kaymantex68/Skruber_Tehnoplast/документация/1.Титульный лист.pdf

| Номер изделия 38.51
Рев. 0 | Дата 22-06-2021

Лабораторный шкаф. Электрическая схема.
