kaymantex68/Skruber_Tehnoplast/Список элементов.xlsx

Позиция | Наименование (номенклатура) | Магазин | Кол-во | Цена со скидкой | Розница | Сумма скидка | Сумма Розинца | Итого скидка | Итого Розинца
1 | Автоматический выключатель Schneider electric iC60N C16A 3p | Авито | 1.00 | 1000.00 | 3200.00 | 1000.00 | 3200.00 | 32667.20 | 40877.00
2 | Автомат защиты двигателя 1,6-2,5A GZ1E07 Schneider Electric | АВС | 2.00 | 1869.60 | 2280.00 | 3739.20 | 4560.00
3 | Автомат пуска двигателя ABB 6.3-10А MS116 | ЭТМ | 1.00 | 2009.00 | 2500.00 | 2009.00 | 2500.00
4 | Выключатель автоматический C 16А 1P 6000A Resi9 R9F12116 | ЭТМ | 2.00 | 191.00 | 231.00 | 382.00 | 462.00
5 | Выключатель автоматический C 6А 1P 6000A Resi9 | ЭТМ | 1.00 | 280.00 | 320.00 | 280.00 | 320.00
6 | Контактор 3-пол., 9А 400В AC3 220В 50ГЦ, 1но LC1E0910M5 Schneider electric | АВС | 3.00 | 593.00 | 739.00 | 1779.00 | 2217.00
7 | Реле 4 перекл. контакта 6А 230В AC RXM4AB1P7 Schneider electric | АВС | 1.00 | 602.00 | 865.00 | 602.00 | 865.00
8 | Комплект тонкое реле + розетка 1п/к, 6А, 230В АС/DC, винт. Клемма RSL1PVPU Schneider Electric | АВС | 1.00 | 627.00 | 967.00 | 627.00 | 967.00
9 | Шина нулевая в комбинированном DIN-изоляторе типа "Стойка" ШНИ-8х12-8-КС-С ИЭК | АВС | 2.00 | 134.00 | 220.00 | 268.00 | 440.00
10 | Ящик пластиковый IEK | Русский Свет | 1.00 | 2500.00 | 3800.00 | 2500.00 | 3800.00
11 | DIN-рейка 35х7,5 мм длиной 600 мм | АВС | 1.00 | 238.00 | 309.00 | 238.00 | 309.00
12 | Кабель-канал перфорир. 25х30 5/8 ДКС | АВС | 1.00 | 164.00 | 215.00 | 164.00 | 215.00
13 | Клемма пружинная ST 2,5 мм2 серая BU Phoenix Contact | АВС | 27.00 | 31.00 | 58.00 | 837.00 | 1566.00
14 | Клемма пружинная ST 2,5 мм2 синяя BU Phoenix Contact | АВС | 5.00 | 31.00 | 58.00 | 155.00 | 290.00
15 | Клемма пружинная ST 2,5-TWIN Phoenix Contact | АВС | 2.00 | 40.00 | 65.00 | 80.00 | 130.00
16 | Клемма втычная PT 2,5-PE ж/з Phoenix Contact | АВС | 4.00 | 161.00 | 240.00 | 644.00 | 960.00
17 | Перемычка Phoenix contact | АВС | 1.00 | 150.00 | 180.00 | 150.00 | 180.00
18 | Заглушка | АВС | 4.00 | 20.00 | 30.00 | 80.00 | 120.00
19 | Концевой стопор CLIPFIX 35-5 V0 Phoenix Contact | АВС | 9.00 | 34.00 | 48.00 | 306.00 | 432.00
20 | Маркировка ONKA |  | 1.00 | 240.00 | 240.00 | 240.00 | 240.00
21 | Кнопка зеленая (1НО/1НЗ) XB7NA35 | АВС | 1.00 | 248.00 | 300.00 | 248.00 | 300.00
22 | Кнопка красная (1НО/1НЗ) XB7NA45 | АВС | 1.00 | 248.00 | 300.00 | 248.00 | 300.00
23 | Ревунок | Яндекс | 1.00 | 450.00 | 450.00 | 450.00 | 450.00
24 | ТДМ переключатель с лампочкой | Яндекс | 1.00 | 430.00 | 430.00 | 430.00 | 430.00
25 | Сигнальная лампа-светодиод зеленая 230В XB7EV03MP | АВС | 3.00 | 201.00 | 242.00 | 603.00 | 726.00
26 | Переключатель черный 2 пол. с фикс. (1НО+1НЗ) XB7ND25 | АВС | 1.00 | 422.00 | 509.00 | 422.00 | 509.00
27 | Коробка Влагостойкая | Озон | 1.00 | 1000.00 | 1000.00 | 1000.00 | 1000.00
28 | Таблица на пульт |  | 1.00 | 190.00 | 190.00 | 190.00 | 190.00
29 | Датчик потока воздуха SL101 | из Германии | 1.00 | 12000.00 | 12000.00 | 12000.00 | 12000.00
30 | Кабель ПУГВ 2.5 | АВС | 25.00 | 21.76 | 25.00 | 544.00 | 625.00
31 | Кабель ПУГВ 1.5 | АВС |  |  |  | 150.00 | 210.00
32 | Кабель ПУГВ 0.5 | АВС | 30.00 | 5.00 | 7.00 | 100.00 | 130.00
33 | НШВИ 2.5 | АВС | 100.00 | 1.00 | 1.30 | 100.00 | 130.00
34 | НШВИ 0.5 | АВС | 10.00 | 0.80 | 1.00 | 8.00 | 10.00
35 | Маркировка для принтера |  | 1.00 | 94.00 | 94.00 | 94.00 | 94.00
