kaymantex68/Skruber_Tehnoplast/(list of files, cad)

Other CAD files:
Шкрубер/Схема дискретный датчик.dwg
Шкрубер/Монтажная панель.dwg
Шкрубер/Принципиальная схема.dwg
Шкрубер/Монтажная панель_recover.dwg
