kaymantex68/Skruber_Tehnoplast/Панель управления.pdf

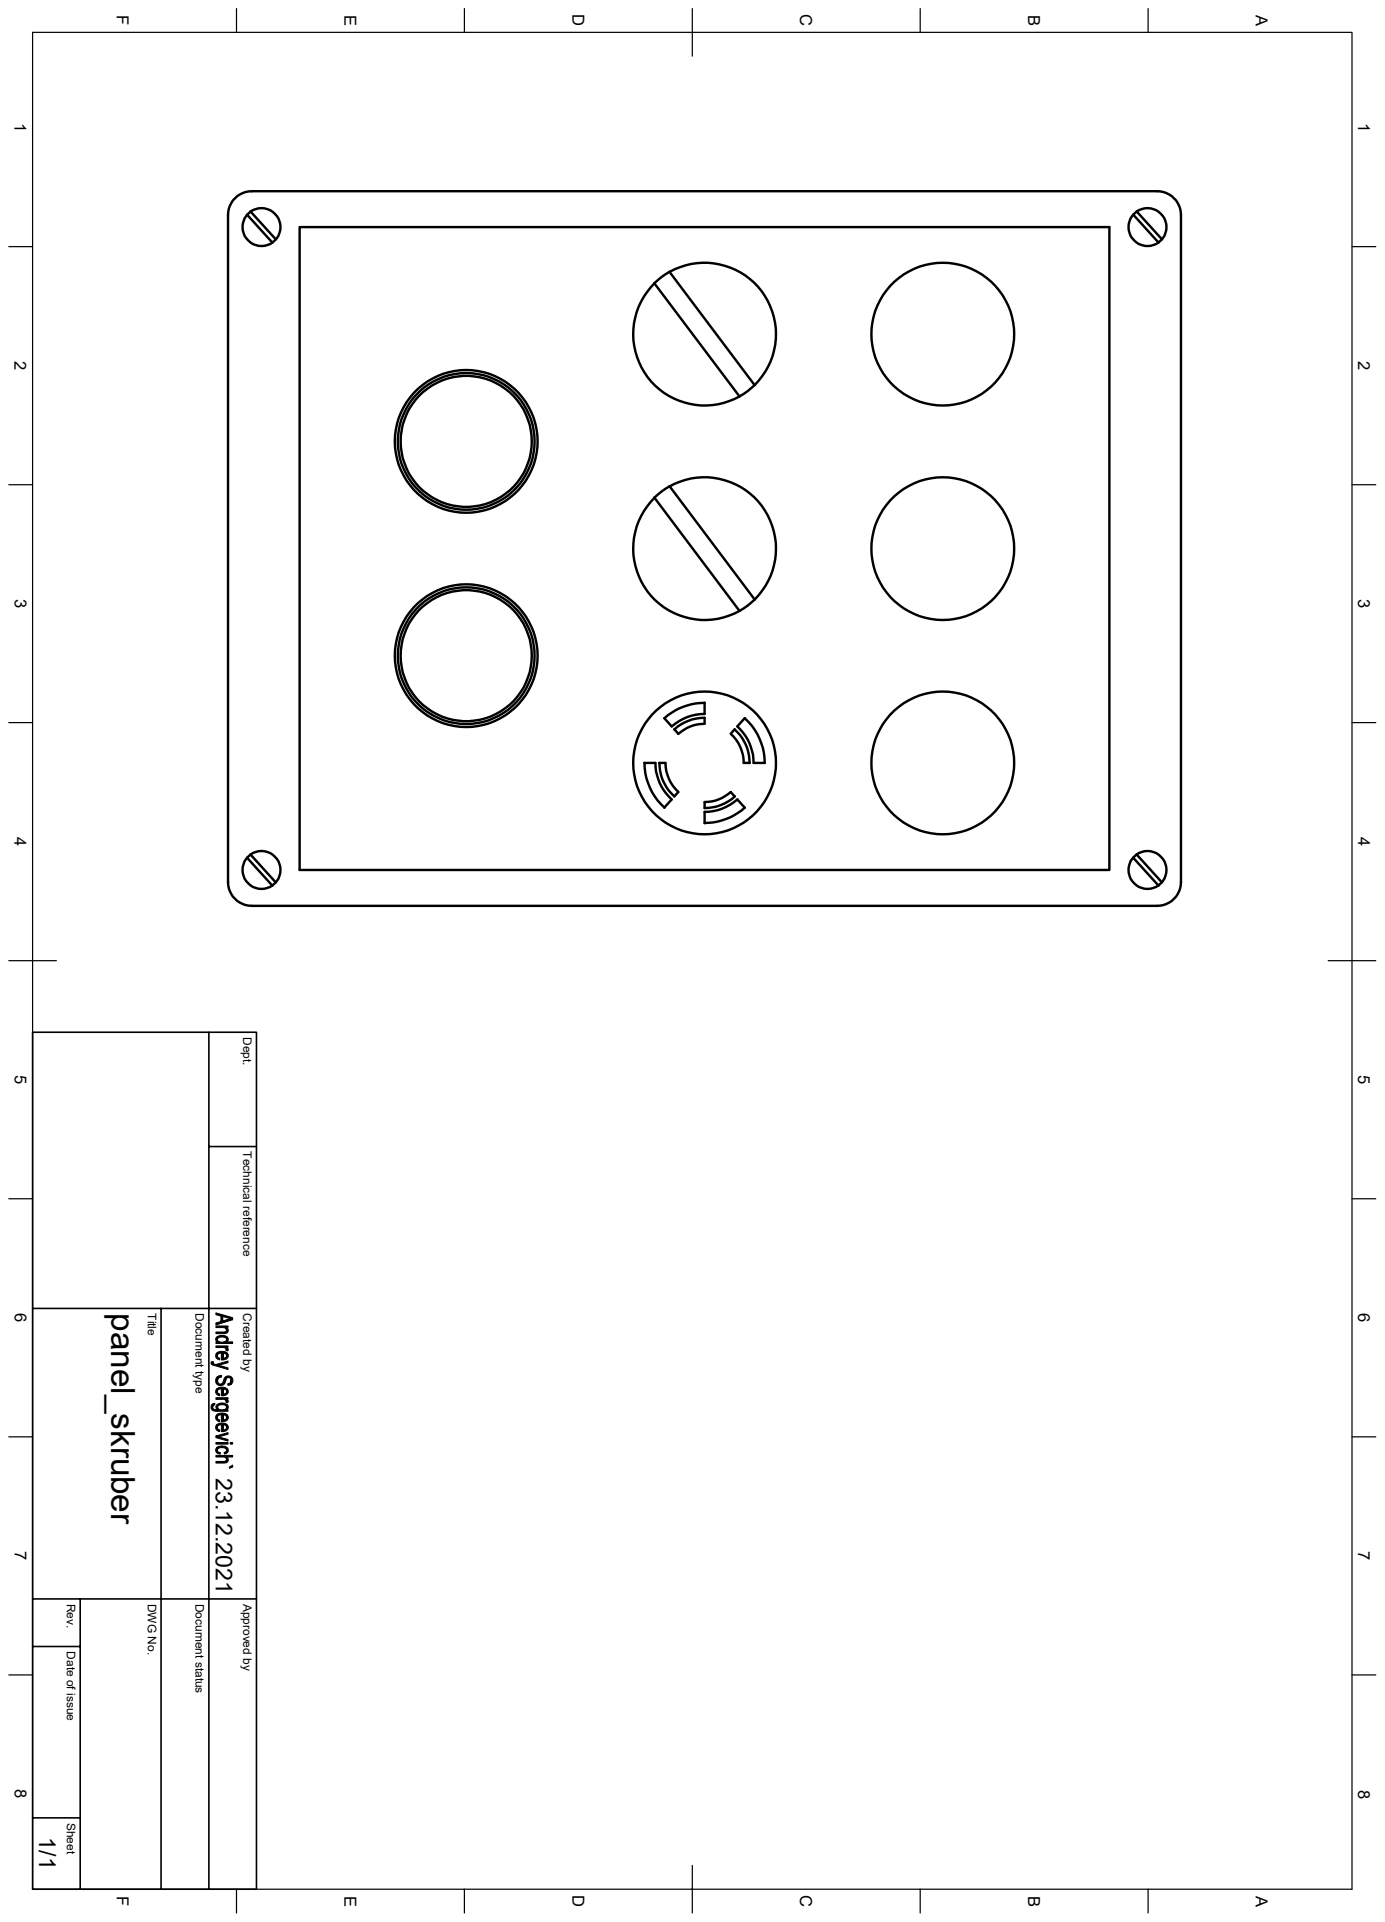
[picture p1: page 1]

1 A 2 3 4 5 6 7 8 1 2 3 4 5 6 7 8 FEDCB FEDCBA Dept. Technical reference Created by Approved by Title DWG No. Document type Document status Rev. Date of issue Sheet 23.12.2021 1/1 panel_skruber
