kaymantex68/Skruber_Tehnoplast/Монтажная панель версия 2.pdf

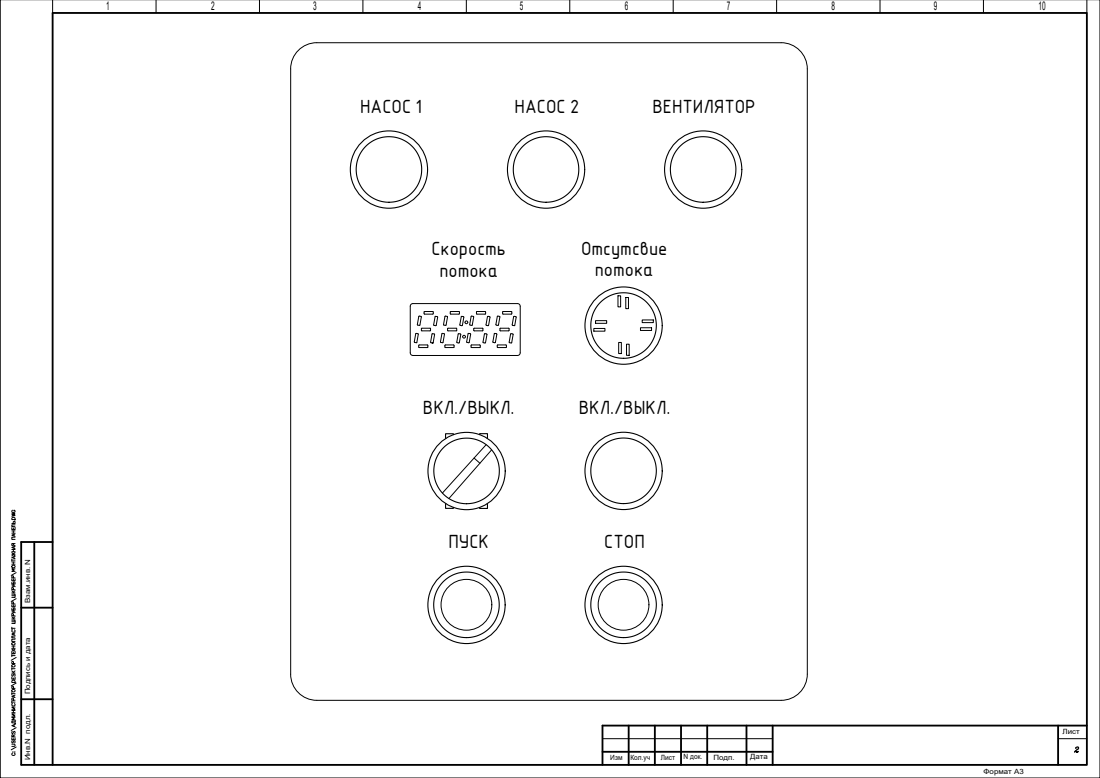
[picture p2: page 1]

Инв.N подл. Подпись и дата Взам.инв. N Формат А3 Изм Кол.уч Лист N док. Подп. Дата Лист ПУСК СТОП Скорость потока Отсутсвие потока ВКЛ./ВЫКЛ. ВКЛ./ВЫКЛ. НАСОС 1 НАСОС 2 ВЕНТИЛЯТОР
