kaymantex68/Skruber_Tehnoplast/Внешняя панель.pdf

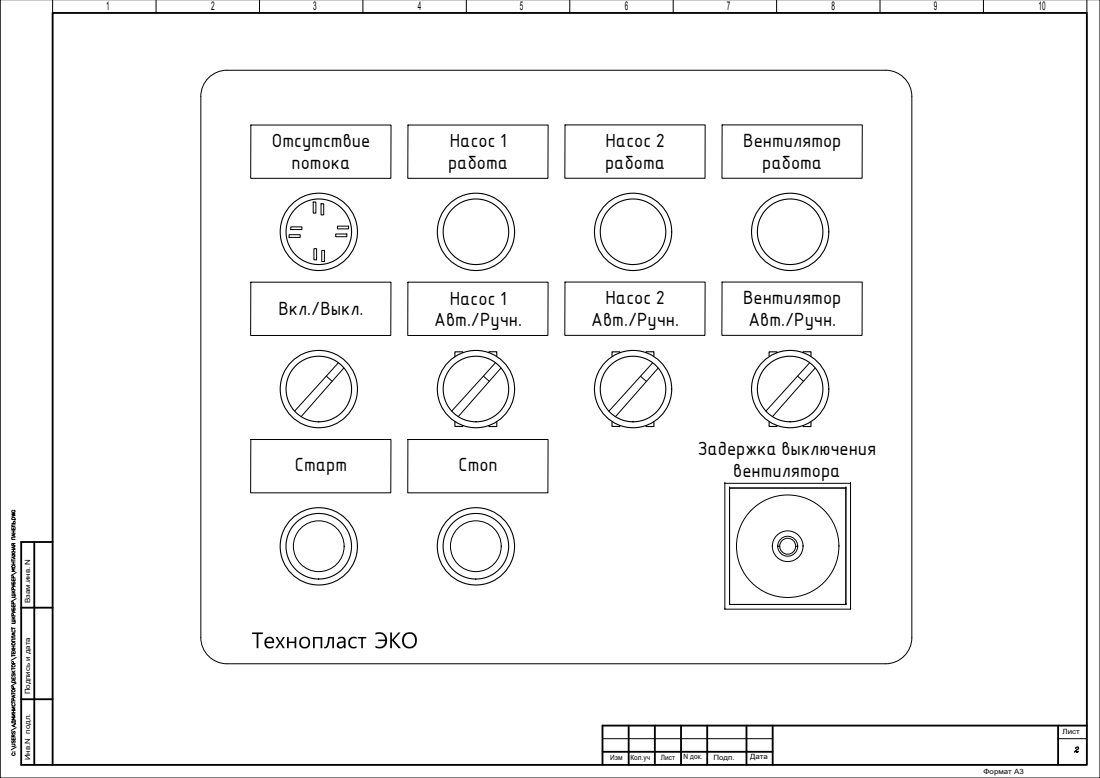
[picture p3: page 1]

Инв.N подл. Подпись и дата Взам.инв. N Формат А3 Изм Кол.уч Лист N док. Подп. Дата Лист Отсутствие потока Насос 1 работа Насос 2 работа Вентилятор работа Вкл./Выкл. Насос 1 Авт./Ручн. Насос 2 Авт./Ручн. Вентилятор Авт./Ручн. Старт Стоп Задержка выключения вентилятора
