kaymantex68/Skruber_Tehnoplast/Принципиальная схем (вер.2).pdf

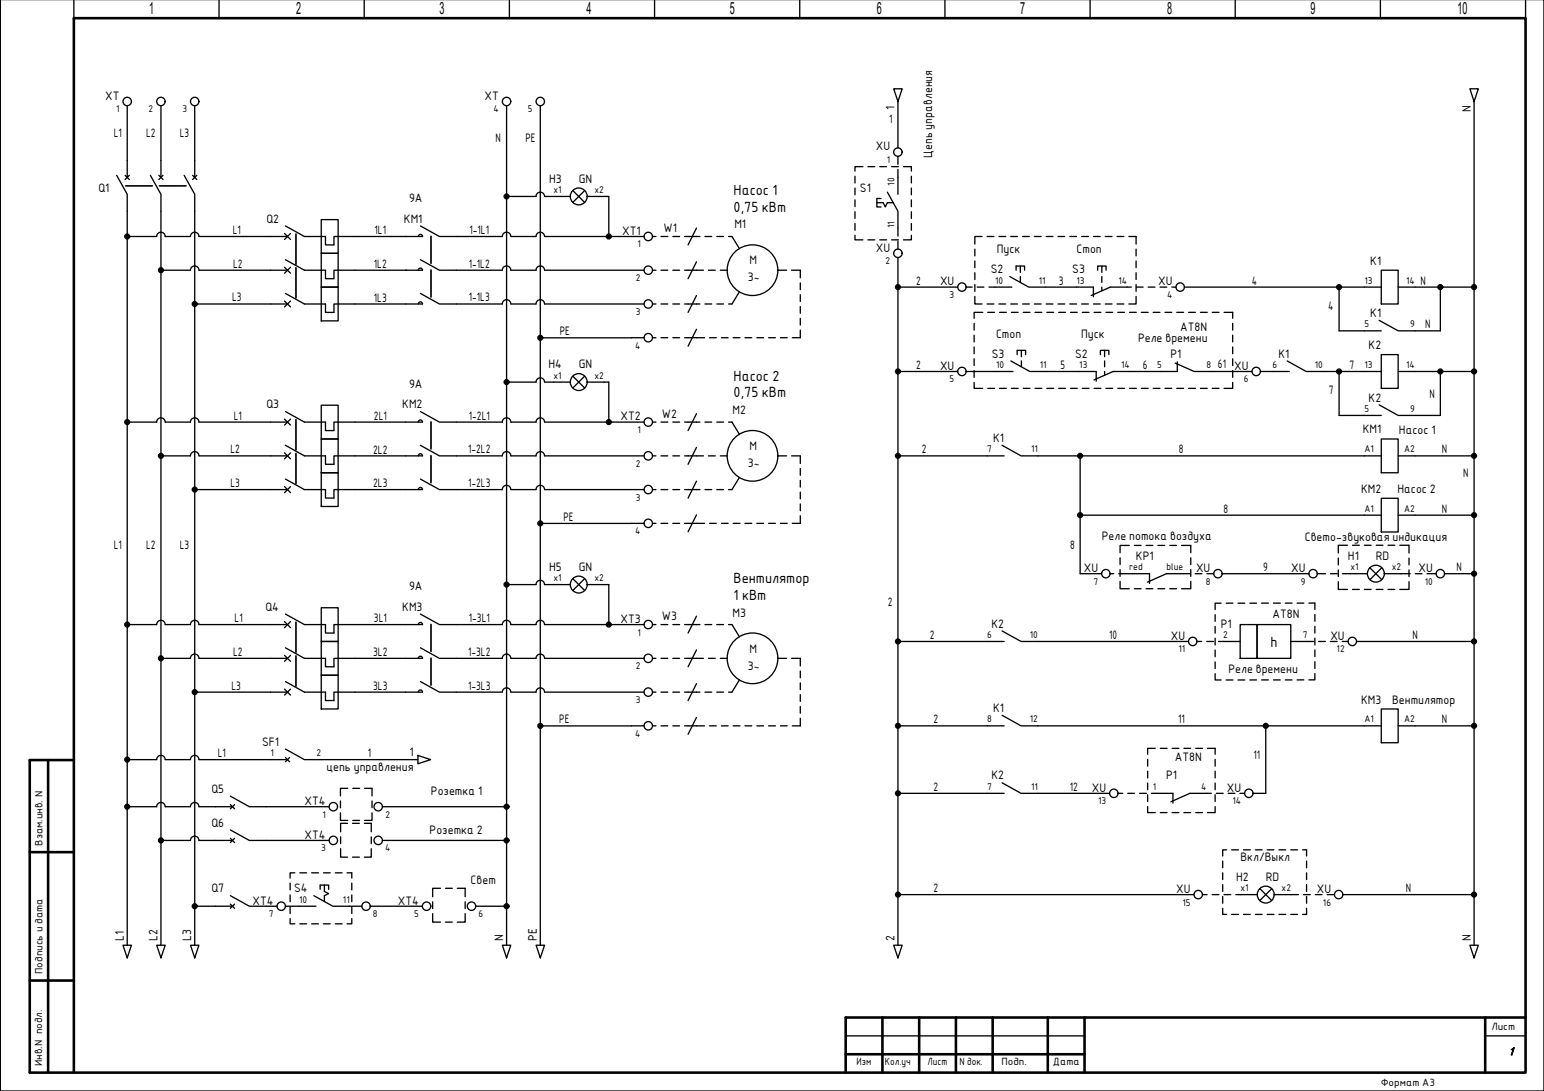
[picture p4: page 1]

Инв.N подл. Подпись и дата Взам.инв. N Формат А3 Изм Кол.уч Лист N док. Подп. Дата Лист XT1 2 3 Q1 Q2 9A KM1 Q3 9A KM2 Q4 9A KM3 1 2 SF1 XT4 5 M3~ M1 M3~ M2 M3~ M3 1 XT12341 XT22341 XT3234 L1 L2 L3 N PE L1 L2 L3 L1 L1L2L3L1 L2L3L1 L2 L3 1L1 1L2 1L3 2L1 2L2 2L3 3L1 3L2 3L3 1-1L1 1-1L2 1-1L3 1-2L1 1-2L2 1-2L3 1-3L1 1-3L2 1-3L3 PEPE PE W1 W2 W3

11 10 S1 XU1 XU2 10 11 Пуск S2 13 14 Стоп S3 3 XU 4 XU K1 13 14 K1 5 9 10 11 Стоп S3 13 14 Пуск S2 5 XU 6 XU K1 6 10 K2 13 14 K2 5 9 K1 7 11 A1 A2 KM1 Насос 1 A1 A2 KM2 Насос 2 x1 x2 Свето-звуковая индикация KP1 H1 RD Реле потока воздуха red blue 7 XU 8 XU 9 XU 10 XU K2 6 10 h 2 7 Реле времени AT8N P1 11 XU 12 XU K1 8 12 A1 A2 KM3 Вентилятор K2 7 11 P1AT8N 1 4 13 XU 14 XUx1 x2 Вкл/Выкл H2 RD 15 XU 16 XU 2 3 4 5 6 7 8 9 10 11 12 222 2222 NN 47 N N 8 N 8 N N N 11 N x1 x2 H3 GN x1 x2 H4 GN x1 x2 H5 GN 2N Q5Q6Q7 Розетка 1 1 XT4 2 Розетка 2 3 XT4 4 Свет 5 XT4 6 10 11 S4 7 XT4 8 Насос 1 0,75 кВт Насос 2 0,75 кВт Вентилятор 1 кВт P1AT8N Реле времени 5 8 61
