kaymantex68/Skruber_Tehnoplast/документация/4.Монтажная панель.pdf

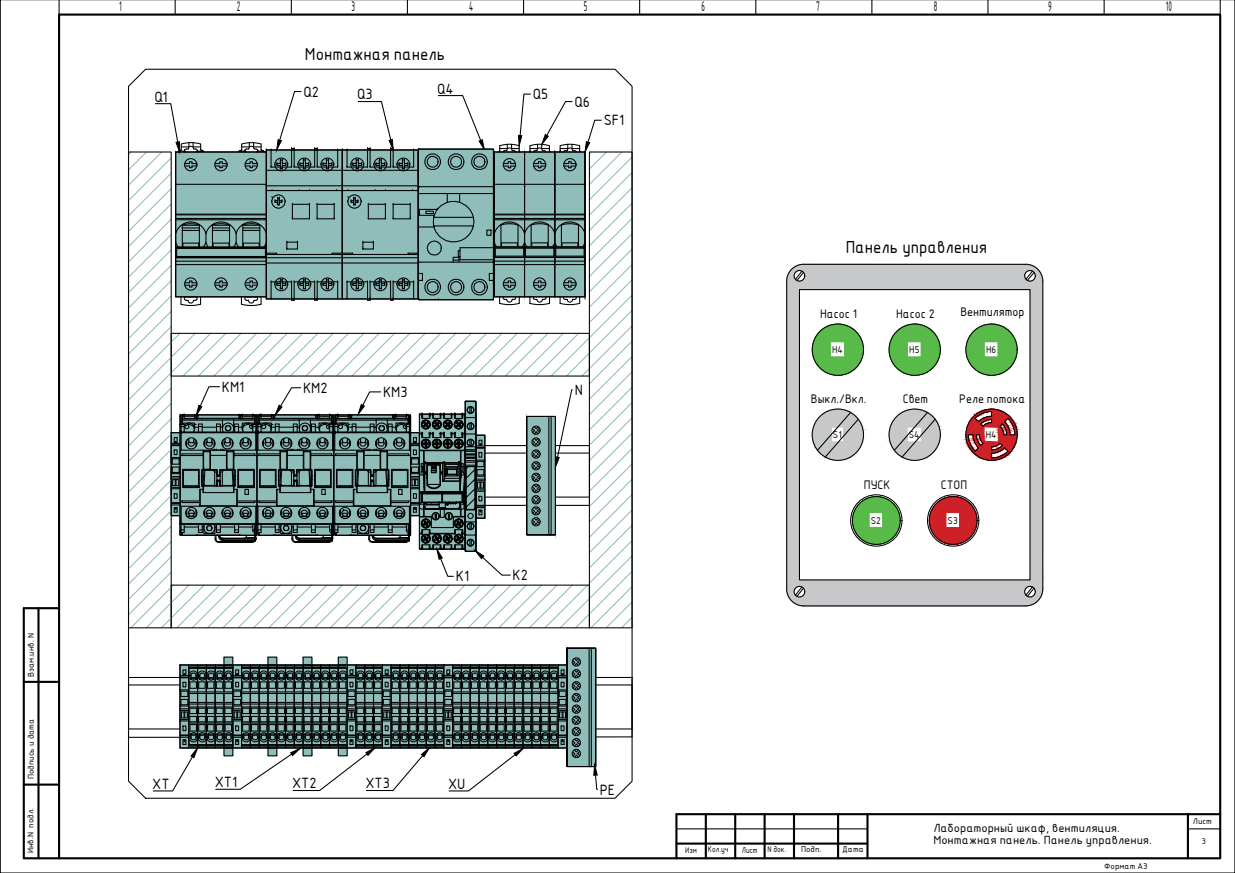
[picture p5: page 1]

Инв.N подл. Подпись и дата Взам.инв. N Формат А3 Изм Кол.уч Лист N док. Подп. Дата Лист3 Лабораторный шкаф, вентиляция. Монтажная панель. Панель управления. H4 H5 H6 S1 S4 H4 S2 S3 Насос 1 Насос 2 Вентилятор Выкл./Вкл. Свет Реле потока ПУСК СТОП Монтажная панель Панель управления
