kaymantex68/Skruber_Tehnoplast/документация/2.Принципиальная схема.pdf

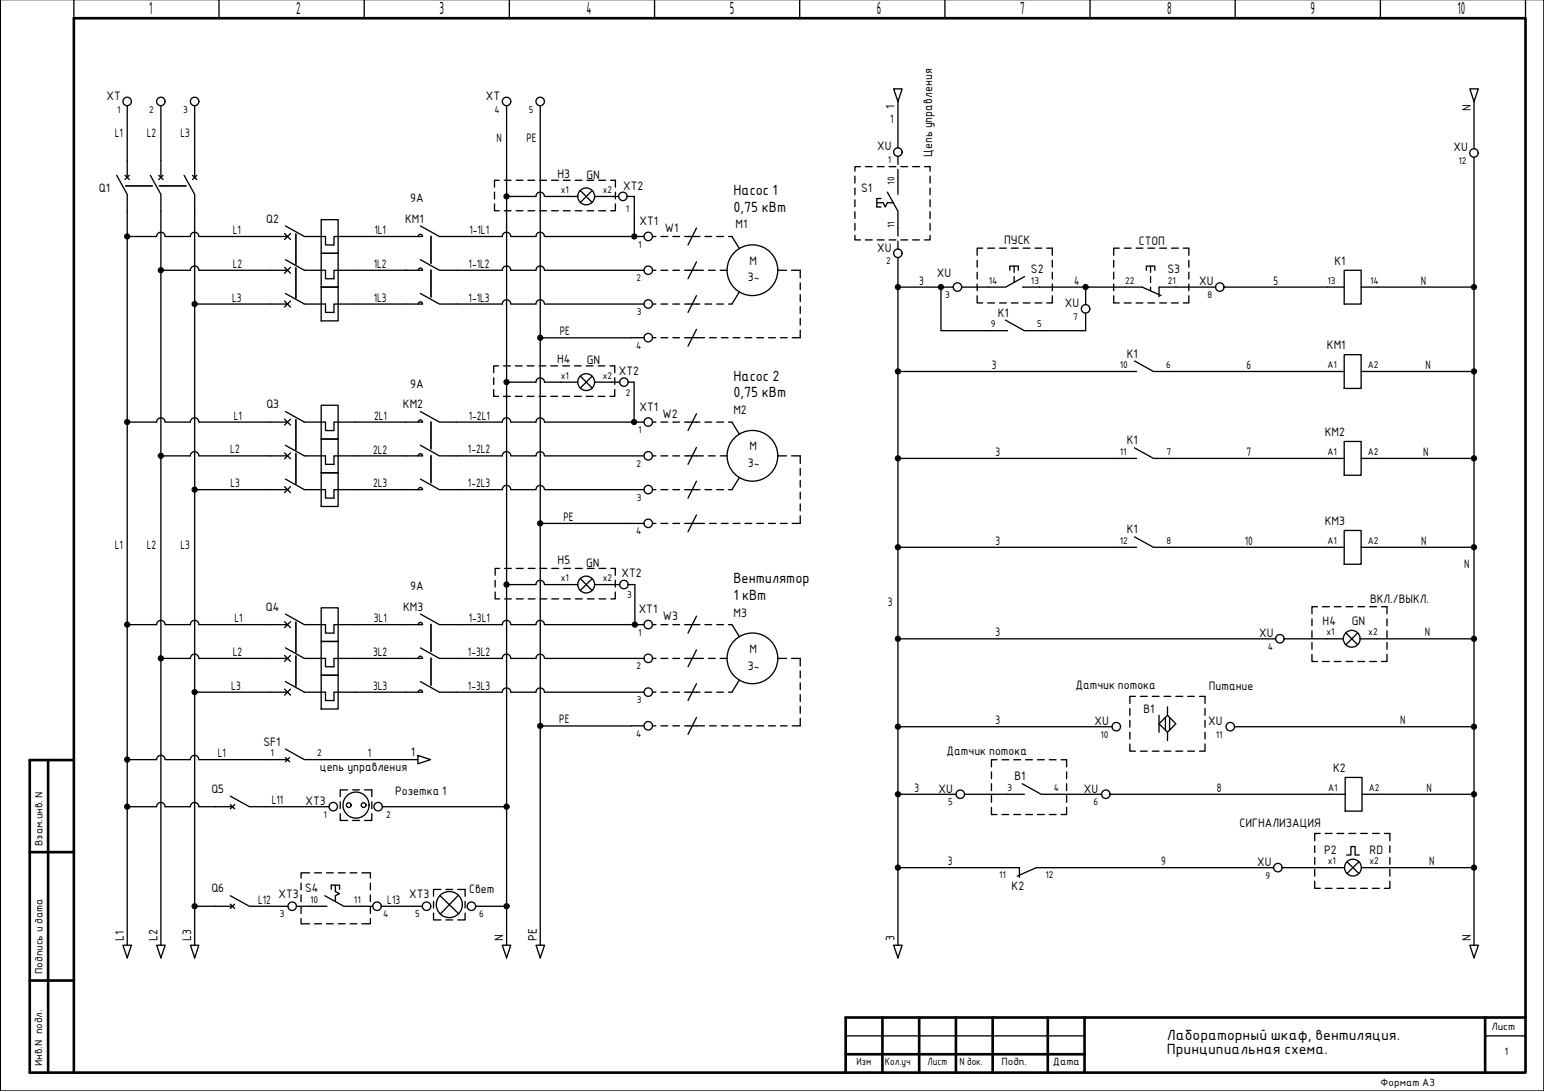
[picture p6: page 1]

Инв.N подл. Подпись и дата Взам.инв. N Формат А3 Изм Кол.уч Лист N док. Подп. Дата Лист1 XT1 2 3 Q1 Q2 9A KM1 Q3 9A KM2 Q4 9A KM3 1 2 SF1 XT4 5 M3~ M1 M3~ M2 M3~ M3 1XT1 2341XT1 2341XT1 234 L1 L2 L3 N PE L1 L2 L3 L1 L1 L2L3L1 L2L3L1 L2 L3 1L1 1L2 1L3 2L1 2L2 2L3 3L1 3L2 3L3 1-1L1 1-1L2 1-1L3 1-2L1 1-2L2 1-2L3 1-3L1 1-3L2 1-3L3 PEPE PE W1 W2 W3

11 10 S1 XU1 XU2 x1 x2 H3 GN x1 x2 H4 GN x1 x2 H5 GN 3N Q5Q6 Розетка 1 1 XT3 2 Свет 5XT3 6 10 11 S4 3XT3 4 Насос 1 0,75 кВт Насос 2 0,75 кВт Вентилятор 1 кВт 1XT2 2 XT23XT2 14 13 ПУСКS2 22 21 СТОП S3 K1 13 14 K1 9 5 3 XU XU7 K1 10 6 A1 A2 KM1 K1 11 7 A1 A2 KM2 K1 12 8 A1 A2 KM3 x1 x2ВКЛ./ВЫКЛ. H4 GN 4 XU 10 XU 11 XU Датчик потока Питание B1 B1 Датчик потока 3 4 5 XU 6 XU K2 A1 A2 K2 11 12 x1 x2 СИГНАЛИЗАЦИЯ P2 RD 9 XU XU12 8 XU NNNNN N NN L11 L12 L13 3 4 5 67 8 9 10 3 33333 3 3 Лабораторный шкаф, вентиляция. Принципиальная схема.
