kaymantex68/Skruber_Tehnoplast/документация/3.Клеммная колодка.pdf

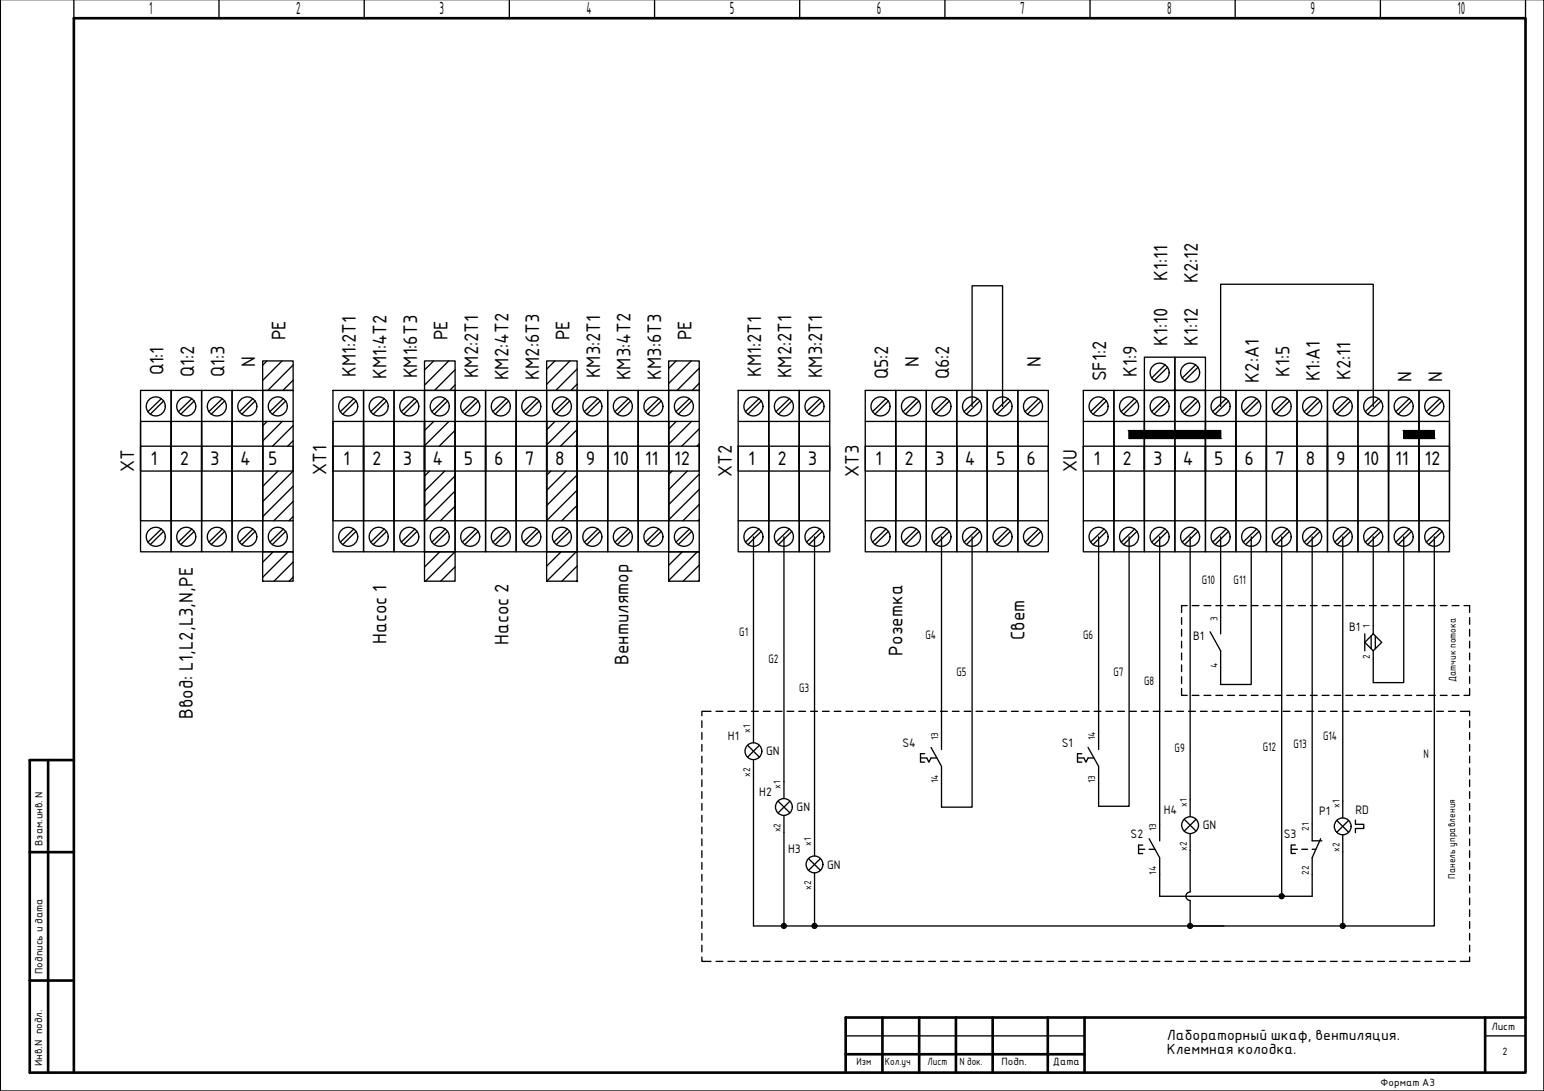
[picture p7: page 1]
Панель управления; Ввод: L1,L2,L3,N,PE; Насос 1; Насос 2; Розетка G1 Свет G2 G3 G4 G5 G6 G7 G8 G9 G10 G11 G12 G13 G14 N

Инв.N подл. Подпись и дата Взам.инв. N Формат А3 Изм Кол.уч Лист N док. Подп. Дата Лист2 1 2 3 4 5 1 2 3 4 5 6 7 8 9 10 11 12 1 2 3 1 2 3 4 5 6 7 8 9 10 11

Датчик потока Лабораторный шкаф, вентиляция. Клеммная колодка.
